auhonh/Auhon_BSEPortfolio/Files/cam_mount.step

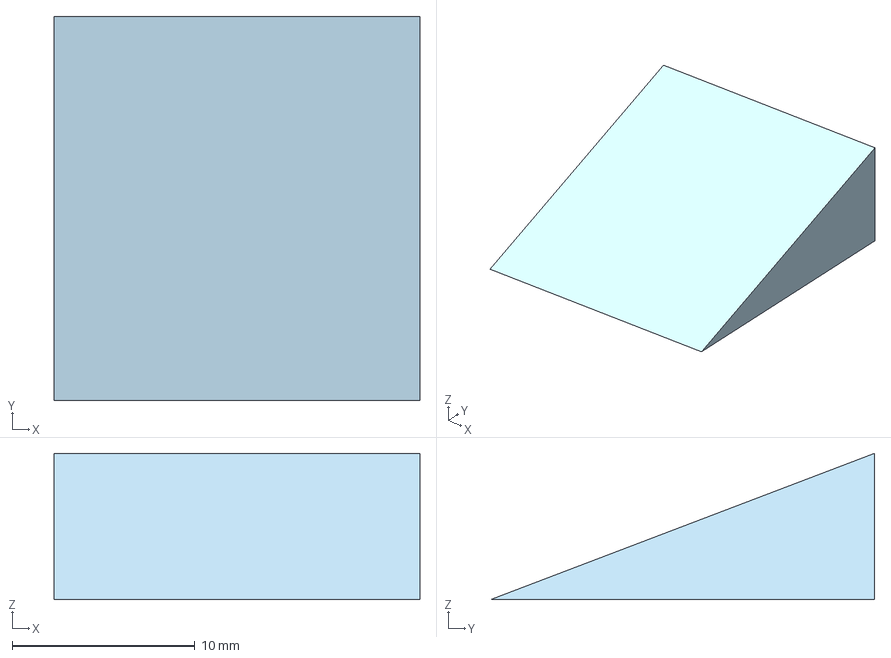
[picture p1: CAD file, 2023-07-14]
Files/cam_mount.step
20.0 x 21.0 x 8.00 mm
