auhonh/Auhon_BSEPortfolio/Files/lower_chassis.step

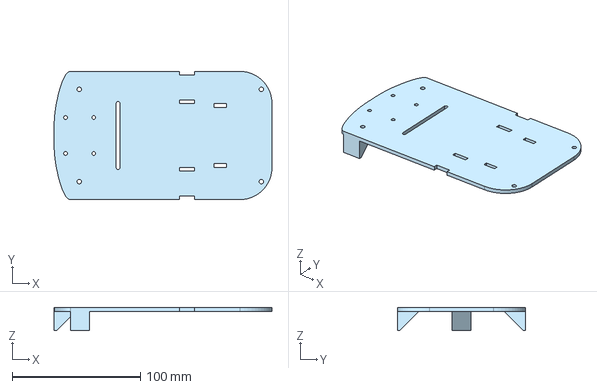
[picture p2: CAD file, 2023-07-14]
Files/lower_chassis.step
170.0 x 100.0 x 18.0 mm
