auhonh/Auhon_BSEPortfolio/Files/upper_chassis.step

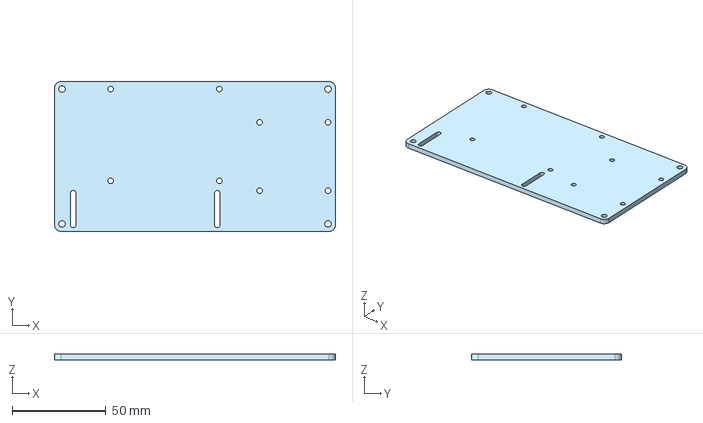
[picture p3: CAD file, 2023-07-14]
Files/upper_chassis.step
150.0 x 80.0 x 3.00 mm
