auhonh/Auhon_BSEPortfolio/Files/lower_plate_drawing.pdf

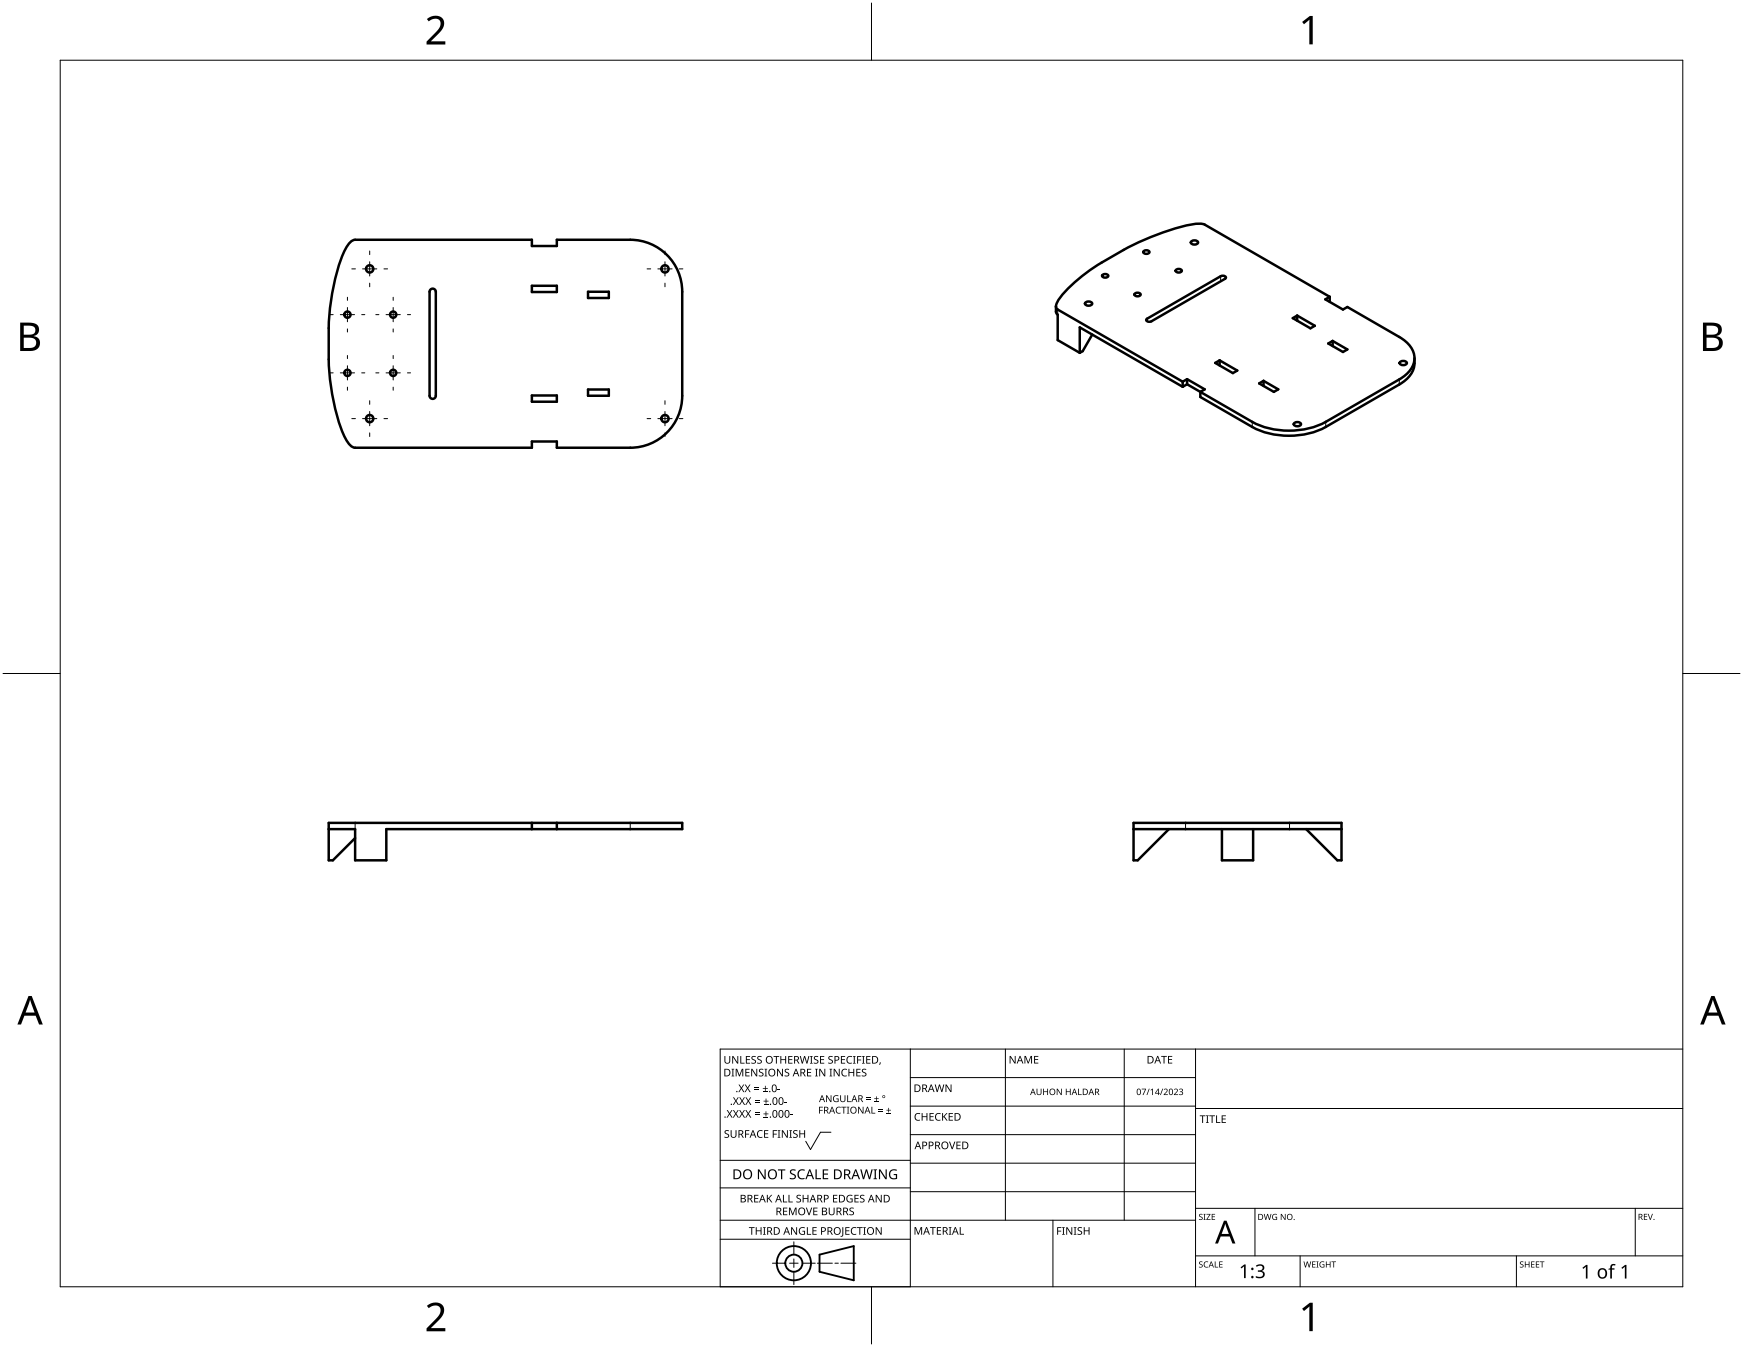
[picture p4: page 1]
