auhonh/Auhon_BSEPortfolio/Files/upper_plate_drawing.pdf

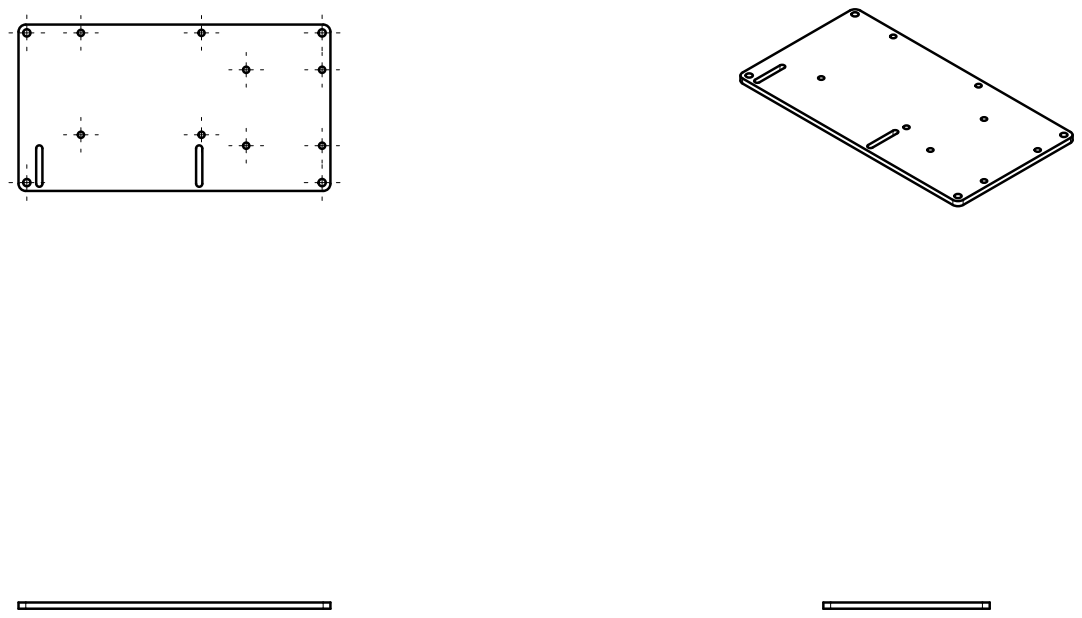
[picture p5: page 1]
